joaovpzdev/howtocyberdeckandstuff/cyberdeck-sar-5k/modelo3d/stl/08_calco_frente_fundo_x4.stl

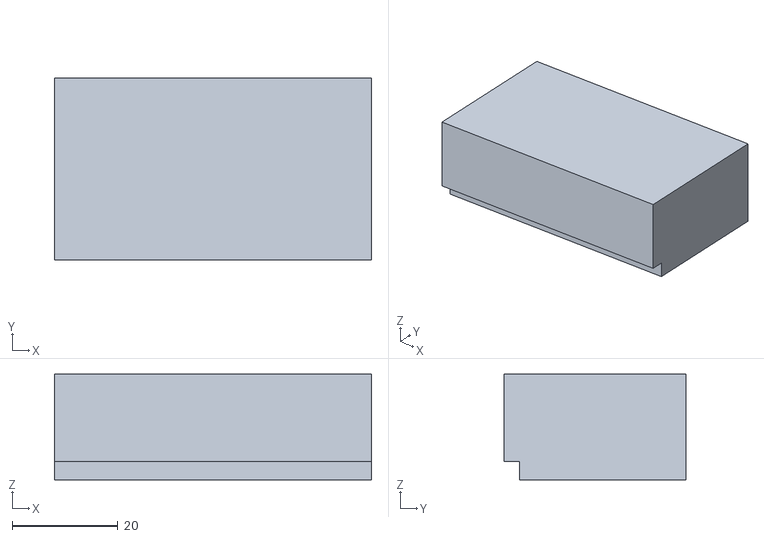
[picture p21: CAD file, 2026-10-19]
cyberdeck-sar-5k/modelo3d/stl/08_calco_frente_fundo_x4.stl
60.0 x 34.5 x 20.0
