joaovpzdev/howtocyberdeckandstuff/cyberdeck-sar-completo/modelo3d/stl/00_montagem_referencia.stl

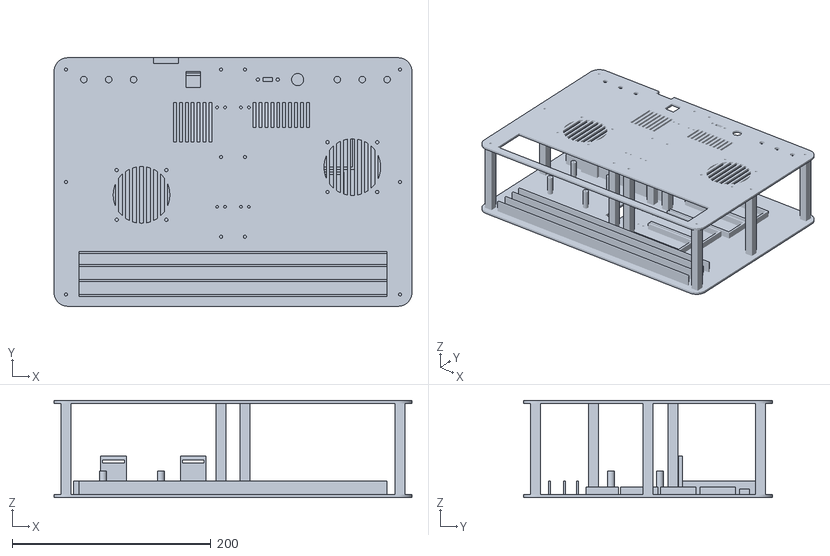
[picture p22: CAD file, 2026-10-19]
cyberdeck-sar-completo/modelo3d/stl/00_montagem_referencia.stl
360.0 x 250.0 x 98.0
