joaovpzdev/howtocyberdeckandstuff/cyberdeck-sar-5k/modelo3d/stl/03_painel_esquerdo.stl

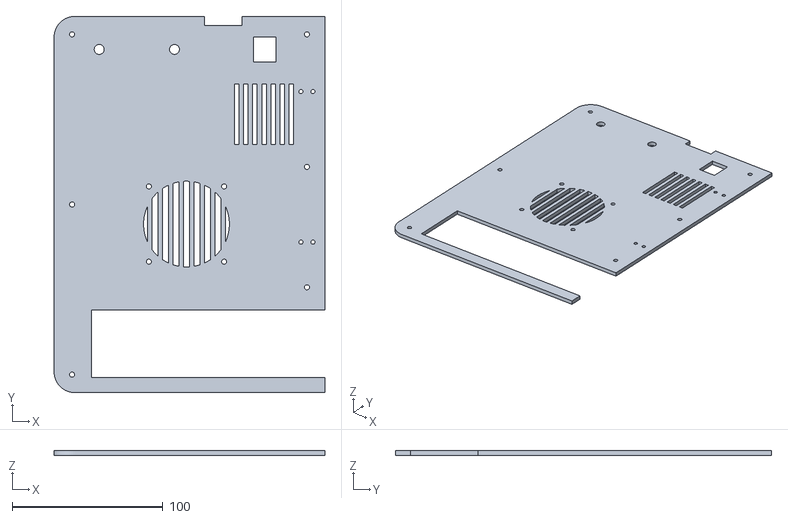
[picture p23: CAD file, 2026-10-19]
cyberdeck-sar-5k/modelo3d/stl/03_painel_esquerdo.stl
180.0 x 250.0 x 3.00
