joaovpzdev/howtocyberdeckandstuff/cyberdeck-sar-completo/modelo3d/stl/01_bandeja_esquerda.stl

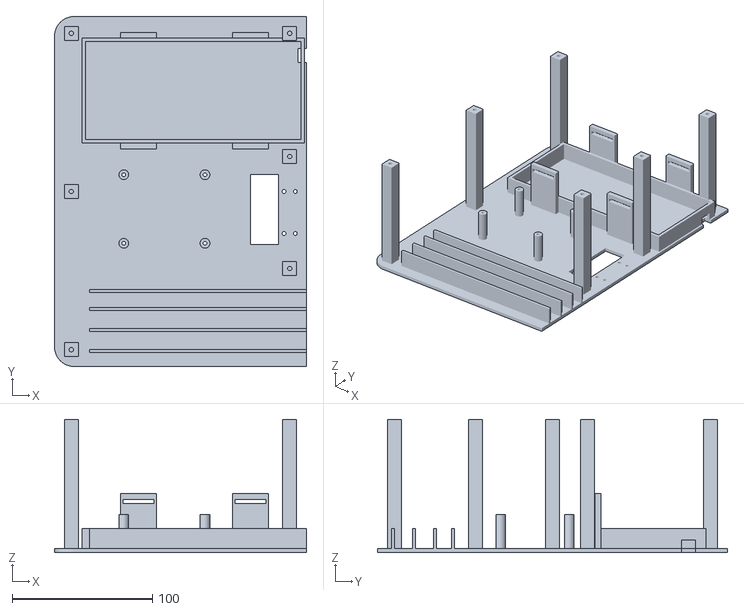
[picture p24: CAD file, 2026-10-19]
cyberdeck-sar-completo/modelo3d/stl/01_bandeja_esquerda.stl
180.0 x 250.0 x 95.0
