joaovpzdev/howtocyberdeckandstuff/cyberdeck-sar-5k/modelo3d/stl/02_bandeja_direita.stl

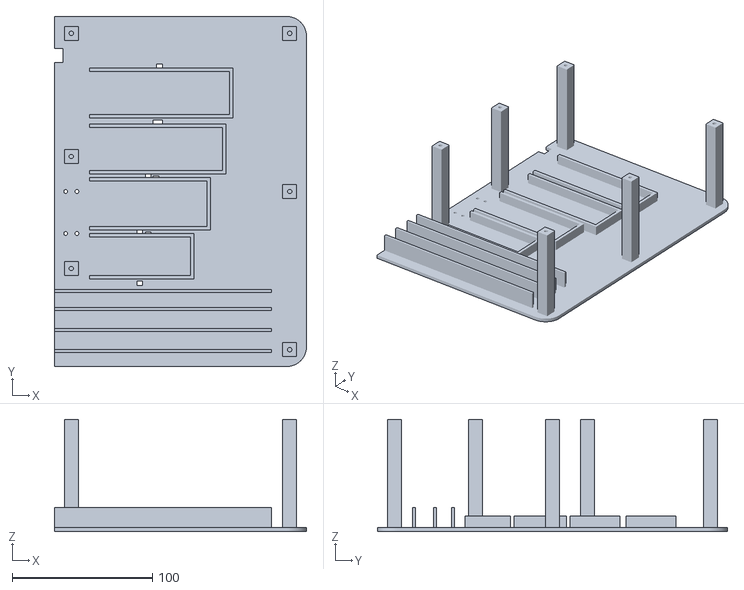
[picture p25: CAD file, 2026-10-19]
cyberdeck-sar-5k/modelo3d/stl/02_bandeja_direita.stl
180.0 x 250.0 x 80.0
