joaovpzdev/howtocyberdeckandstuff/cyberdeck-sar-completo/modelo3d/stl/05_moldura_tela.stl

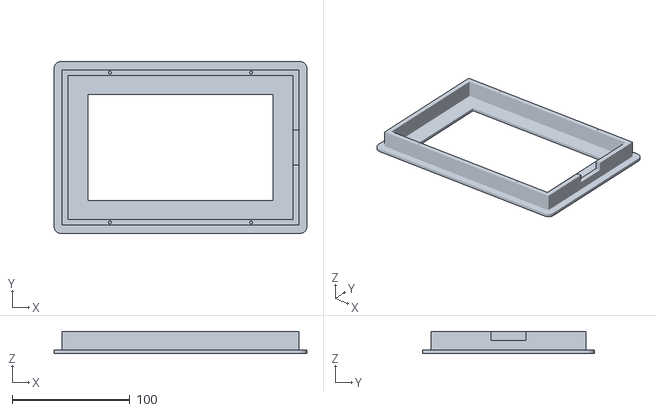
[picture p26: CAD file, 2026-10-19]
cyberdeck-sar-completo/modelo3d/stl/05_moldura_tela.stl
215.0 x 146.0 x 19.0
