joaovpzdev/howtocyberdeckandstuff/cyberdeck-sar-completo/modelo3d/stl/07_tala_emenda_x4.stl

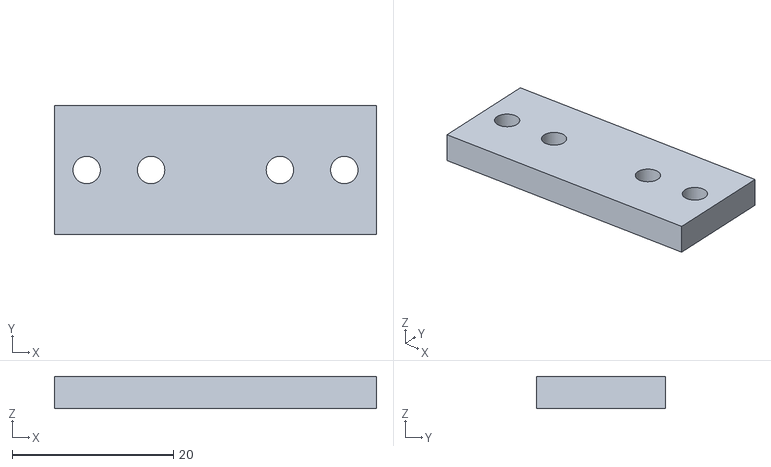
[picture p27: CAD file, 2026-10-19]
cyberdeck-sar-completo/modelo3d/stl/07_tala_emenda_x4.stl
40.0 x 16.0 x 4.00
