joaovpzdev/howtocyberdeckandstuff/cyberdeck-sar-5k/modelo3d/stl/01_bandeja_esquerda.stl

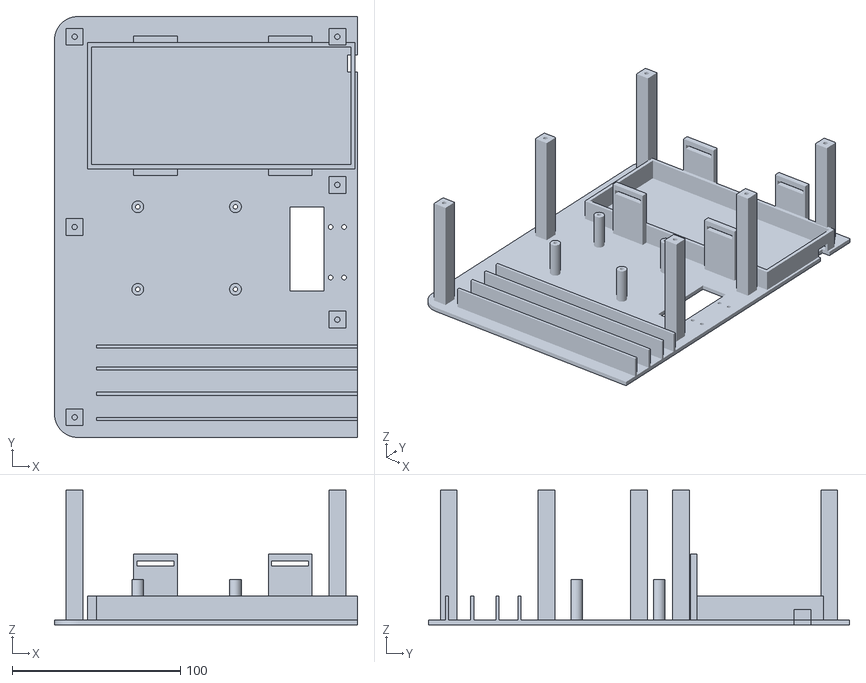
[picture p28: CAD file, 2026-10-19]
cyberdeck-sar-5k/modelo3d/stl/01_bandeja_esquerda.stl
180.0 x 250.0 x 80.0
