joaovpzdev/howtocyberdeckandstuff/cyberdeck-sar-5k/modelo3d/stl/06_travessa_tela_x2.stl

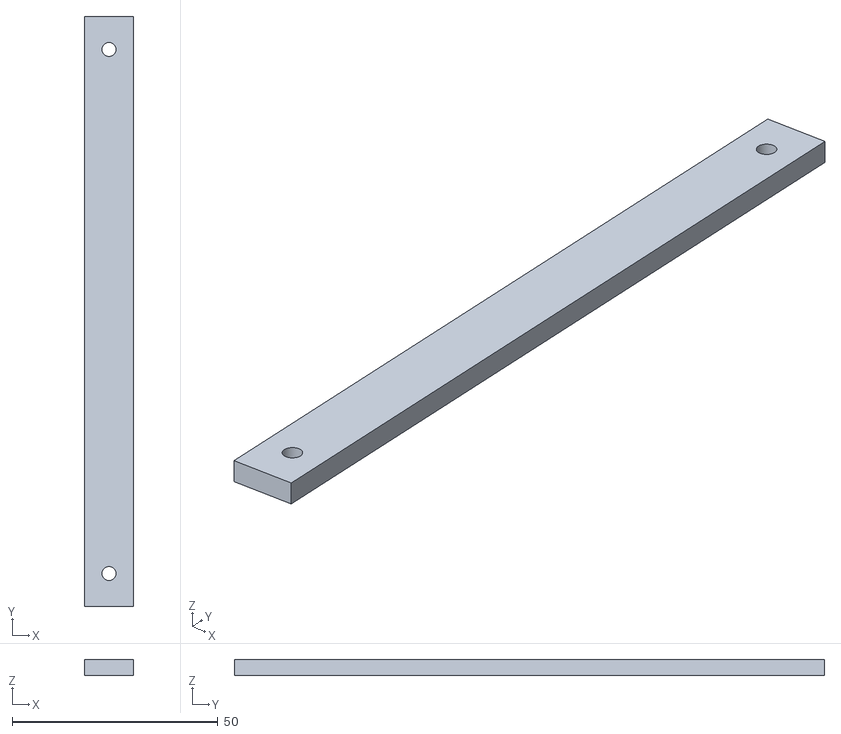
[picture p29: CAD file, 2026-10-19]
cyberdeck-sar-5k/modelo3d/stl/06_travessa_tela_x2.stl
12.0 x 143.2 x 4.00
