joaovpzdev/howtocyberdeckandstuff/cyberdeck-sar-5k/modelo3d/stl/00_montagem_referencia.stl

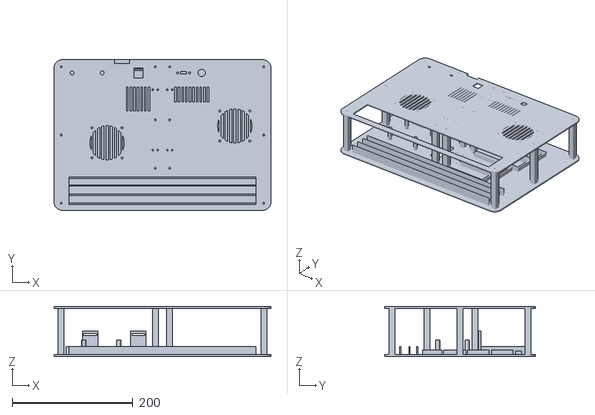
[picture p30: CAD file, 2026-10-19]
cyberdeck-sar-5k/modelo3d/stl/00_montagem_referencia.stl
360.0 x 250.0 x 83.0
