joaovpzdev/howtocyberdeckandstuff/cyberdeck-sar-5k/modelo3d/stl/09_calco_lateral_x2.stl

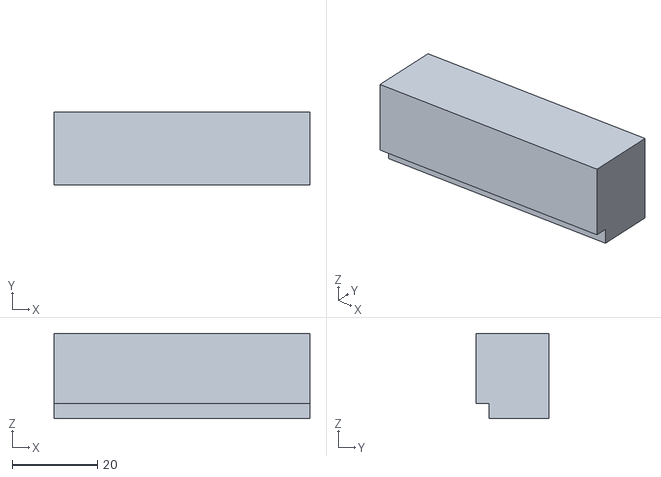
[picture p31: CAD file, 2026-10-19]
cyberdeck-sar-5k/modelo3d/stl/09_calco_lateral_x2.stl
60.0 x 17.0 x 20.0
