joaovpzdev/howtocyberdeckandstuff/(list of files, cad)

Other CAD files:
cyberdeck-sar-5k/modelo3d/stl/04_painel_direito.stl
cyberdeck-sar-completo/modelo3d/stl/04_painel_direito.stl
cyberdeck-sar-completo/modelo3d/stl/02_bandeja_direita.stl
cyberdeck-sar-completo/modelo3d/stl/03_painel_esquerdo.stl
