joaovpzdev/howtocyberdeckandstuff/cyberdeck-sar-5k/cyberdeck_sar_5k_desenho_tecnico.pdf

## CYBERDECK SAR - EDIÇÃO R$ 5 MIL

Patola MP-0039: vistas fechado e aberto em operação

Autor: João Victor Paixão Zolim
github.com/joaovpzdev

Data
17/10/2026

Escala
1:4

Folha
1/4

Unidade
mm

Projeção
1º diedro

Formato
A3

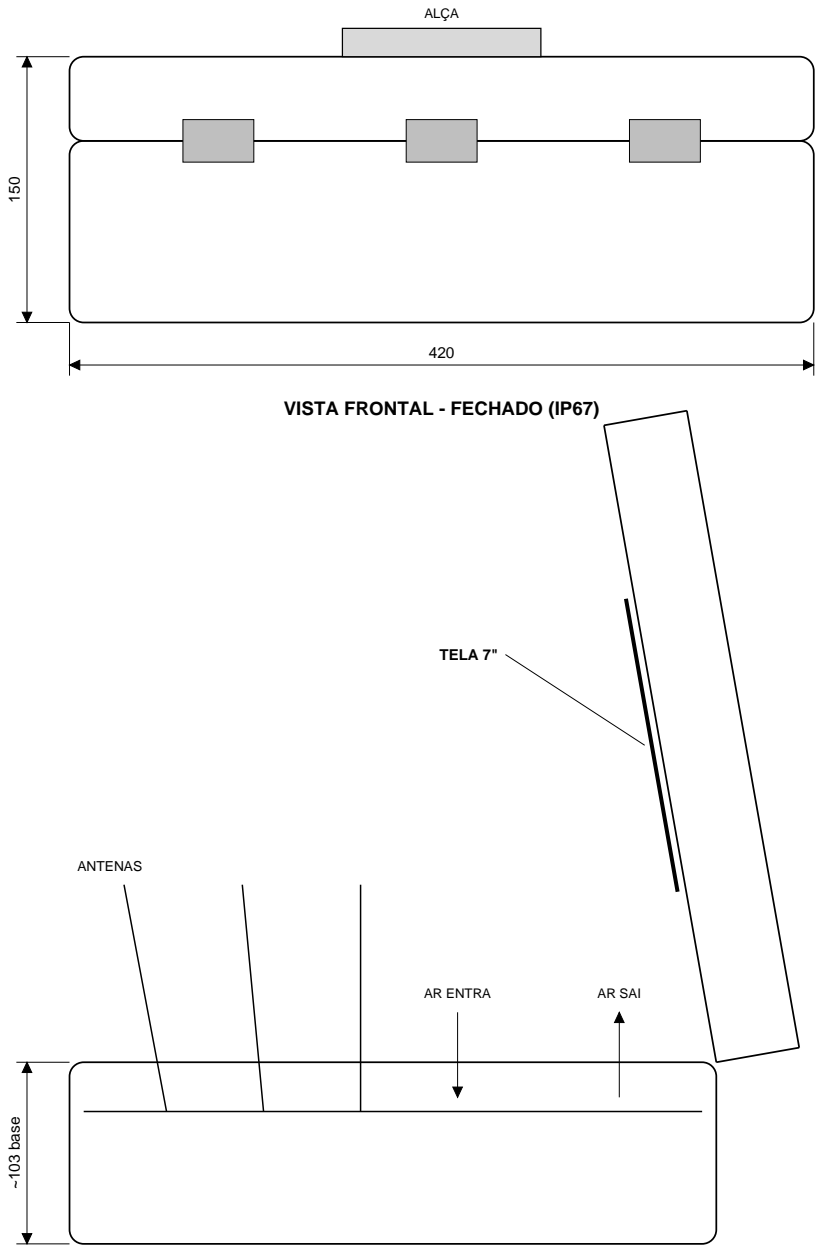
[picture p35: figure]
ALÇA; VISTA FRONTAL - FECHADO (IP67); TELA 7"; ANTENAS; AR ENTRA; AR SAI; ~103 base

DOBRADIÇA

365

### VISTA LATERAL ESQUERDA - FECHADO

### VISTA LATERAL - ABERTO EM OPERAÇÃO

Característica | Patola MP-0039 (fabricado no Brasil)
Externo (C x L x A) | 420 x 365 x 150
Interno (C x L x A) | 390 x 315 x 135
Altura interna da base / tampa | 95 / ~40
Peso vazio | 1,96 kg
Vedação | IP67 (impacto, poeira e água)
Volume interno | 16,6 litros
Compra | Patola Store (loja oficial)
Preço (out/2026) | R$ 486 (MP-0039/1: R$ 440)

Sem furos no case: a vedação IP67 fica intacta para transporte.

Em operação, o kit trabalha aberto e a ventilação é feita pelo painel.

## PROTEÇÃO PARA CLIMA HOSTIL

1. Fechado: IP67 (poeira e submersão temporária).
2. Aberto: operar sob abrigo; chuva direta molha

a tela e o painel. Prever capa/toldo.

3. Filtro de espuma na entrada de ar contra poeira.
4. Verniz conformal (tropicalização) nas placas

contra umidade e maresia.

5. Sachês de sílica gel no case fechado.
6. Peças impressas em ASA ou PETG: PLA deforma

acima de ~55 °C (sol, carro fechado).

7. Li-ion: carregar só entre 0 e 45 °C; no calor

extremo, deixar a tampa aberta e à sombra.

8. Pi 5 reduz o clock a ~85 °C: monitorar via

vcgencmd / agente Zabbix.

9. Recarga sem desmontar: USB-C do painel (tampa

aberta) -> UPS (power bank opcional). Sem furos.

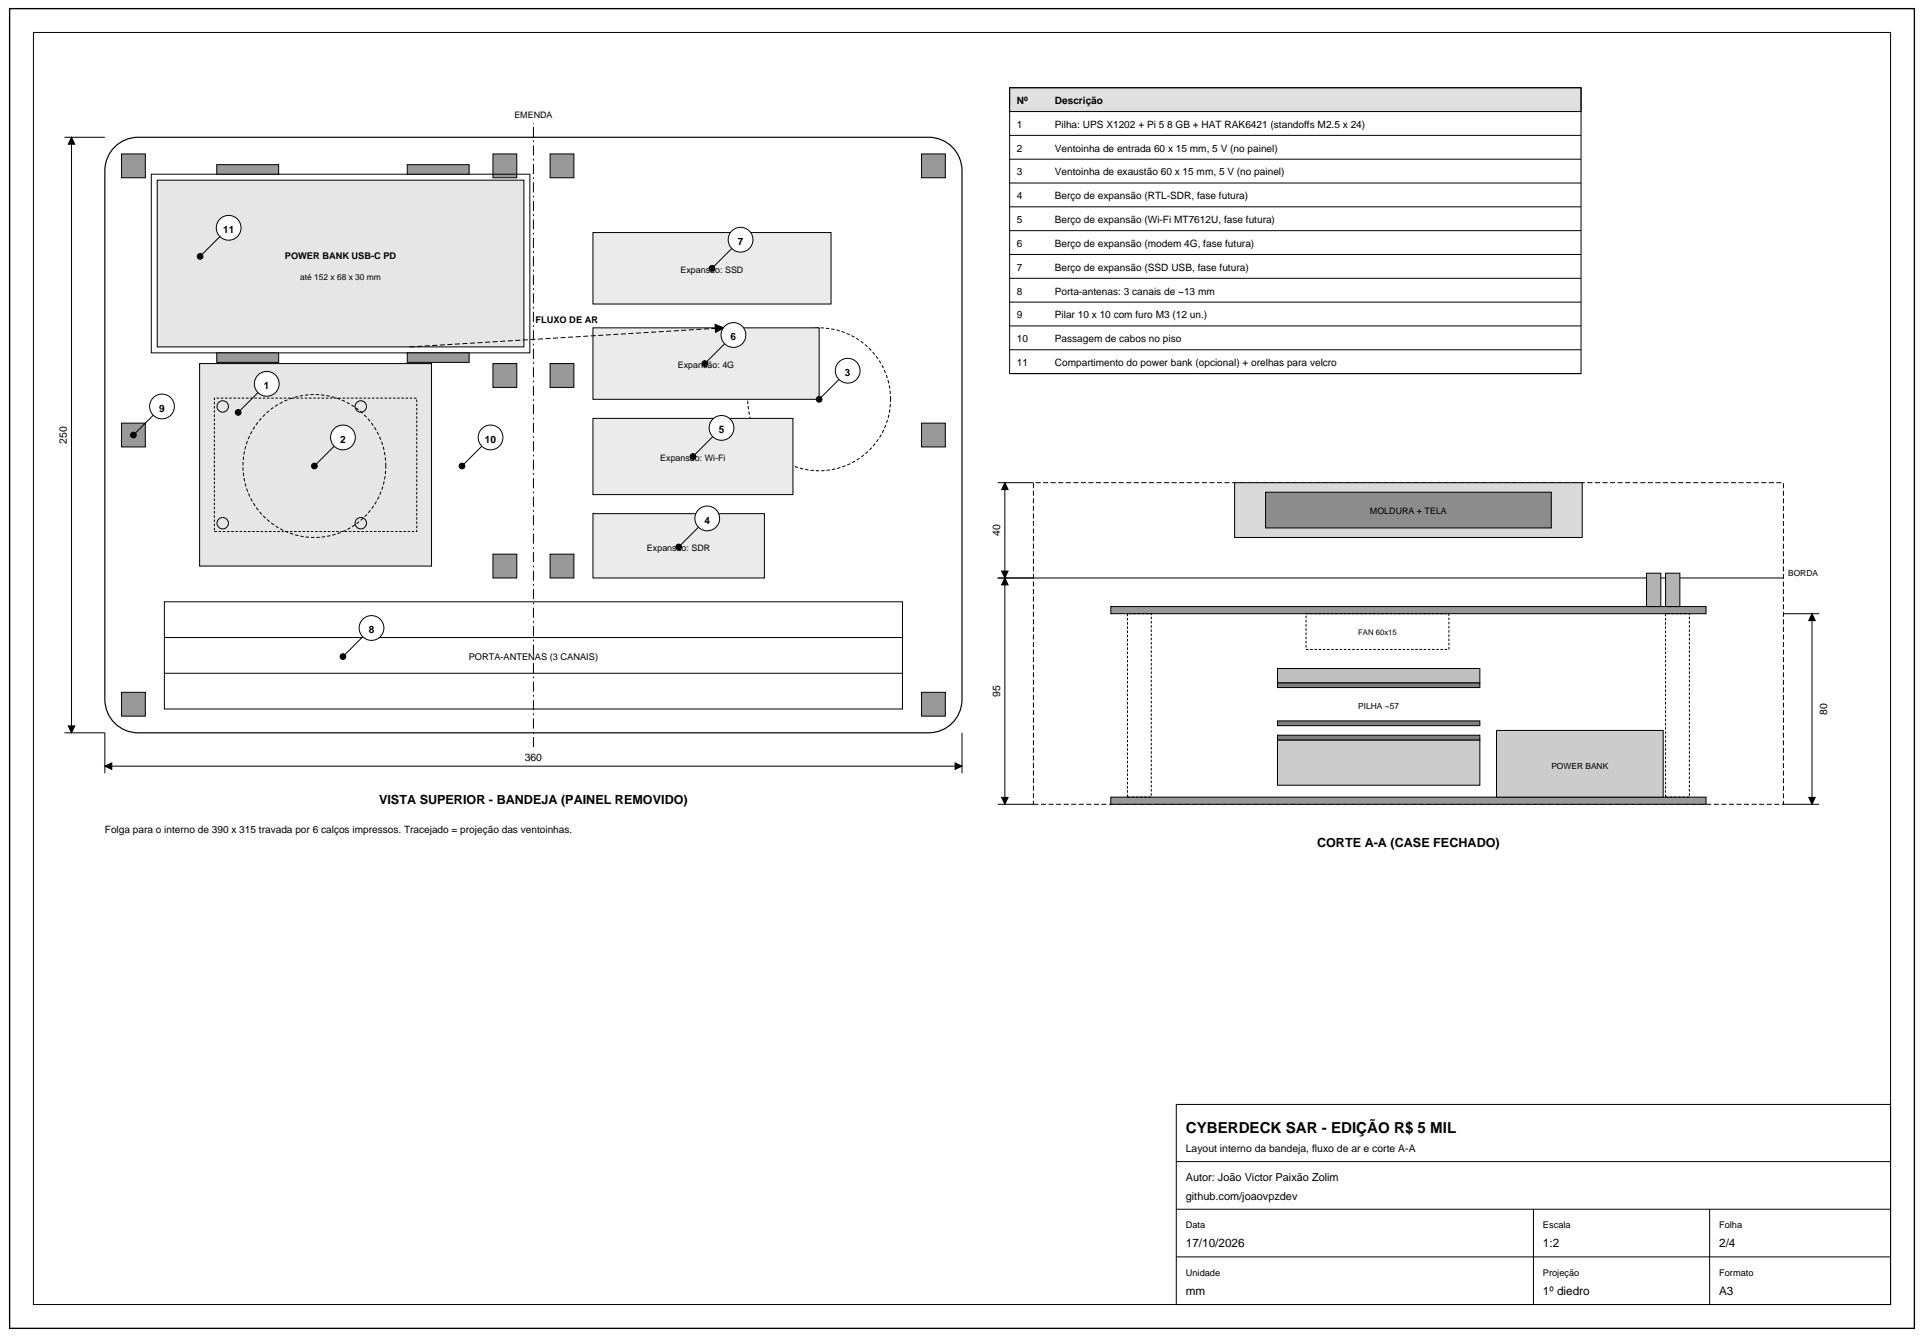
[picture p36: page 2]
Data 17/10/2026; Escala 1:2; Folha 2/4; EMENDA; Expansão: SDR; Expansão: 4G; Expansão: SSD; até 152 x 68 x 30 mm; Descrição; Pilha: UPS X1202 + Pi 5 8 GB + HAT RAK6421 (standoffs M2.5 x 24); Ventoinha de entrada 60 x 15 mm, 5 V (no painel); Ventoinha de exaustão 60 x 15 mm, 5 V (no painel); Berço de expansão (RTL-SDR, fase futura); Berço de expansão (Wi-Fi MT7612U, fase futura); Berço de expansão (modem 4G, fase futura); Berço de expansão (SSD USB, fase futura)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

POWER BANK USB-C PD

FLUXO DE AR

Expansão: Wi-Fi

PORTA-ANTENAS (3 CANAIS)

VISTA SUPERIOR - BANDEJA (PAINEL REMOVIDO)

Folga para o interno de 390 x 315 travada por 6 calços impressos. Tracejado = projeção das ventoinhas.

CORTE A-A (CASE FECHADO)

CYBERDECK SAR - EDIÇÃO R$ 5 MIL

Layout interno da bandeja, fluxo de ar e corte A-A

Autor: João Victor Paixão Zolim
github.com/joaovpzdev

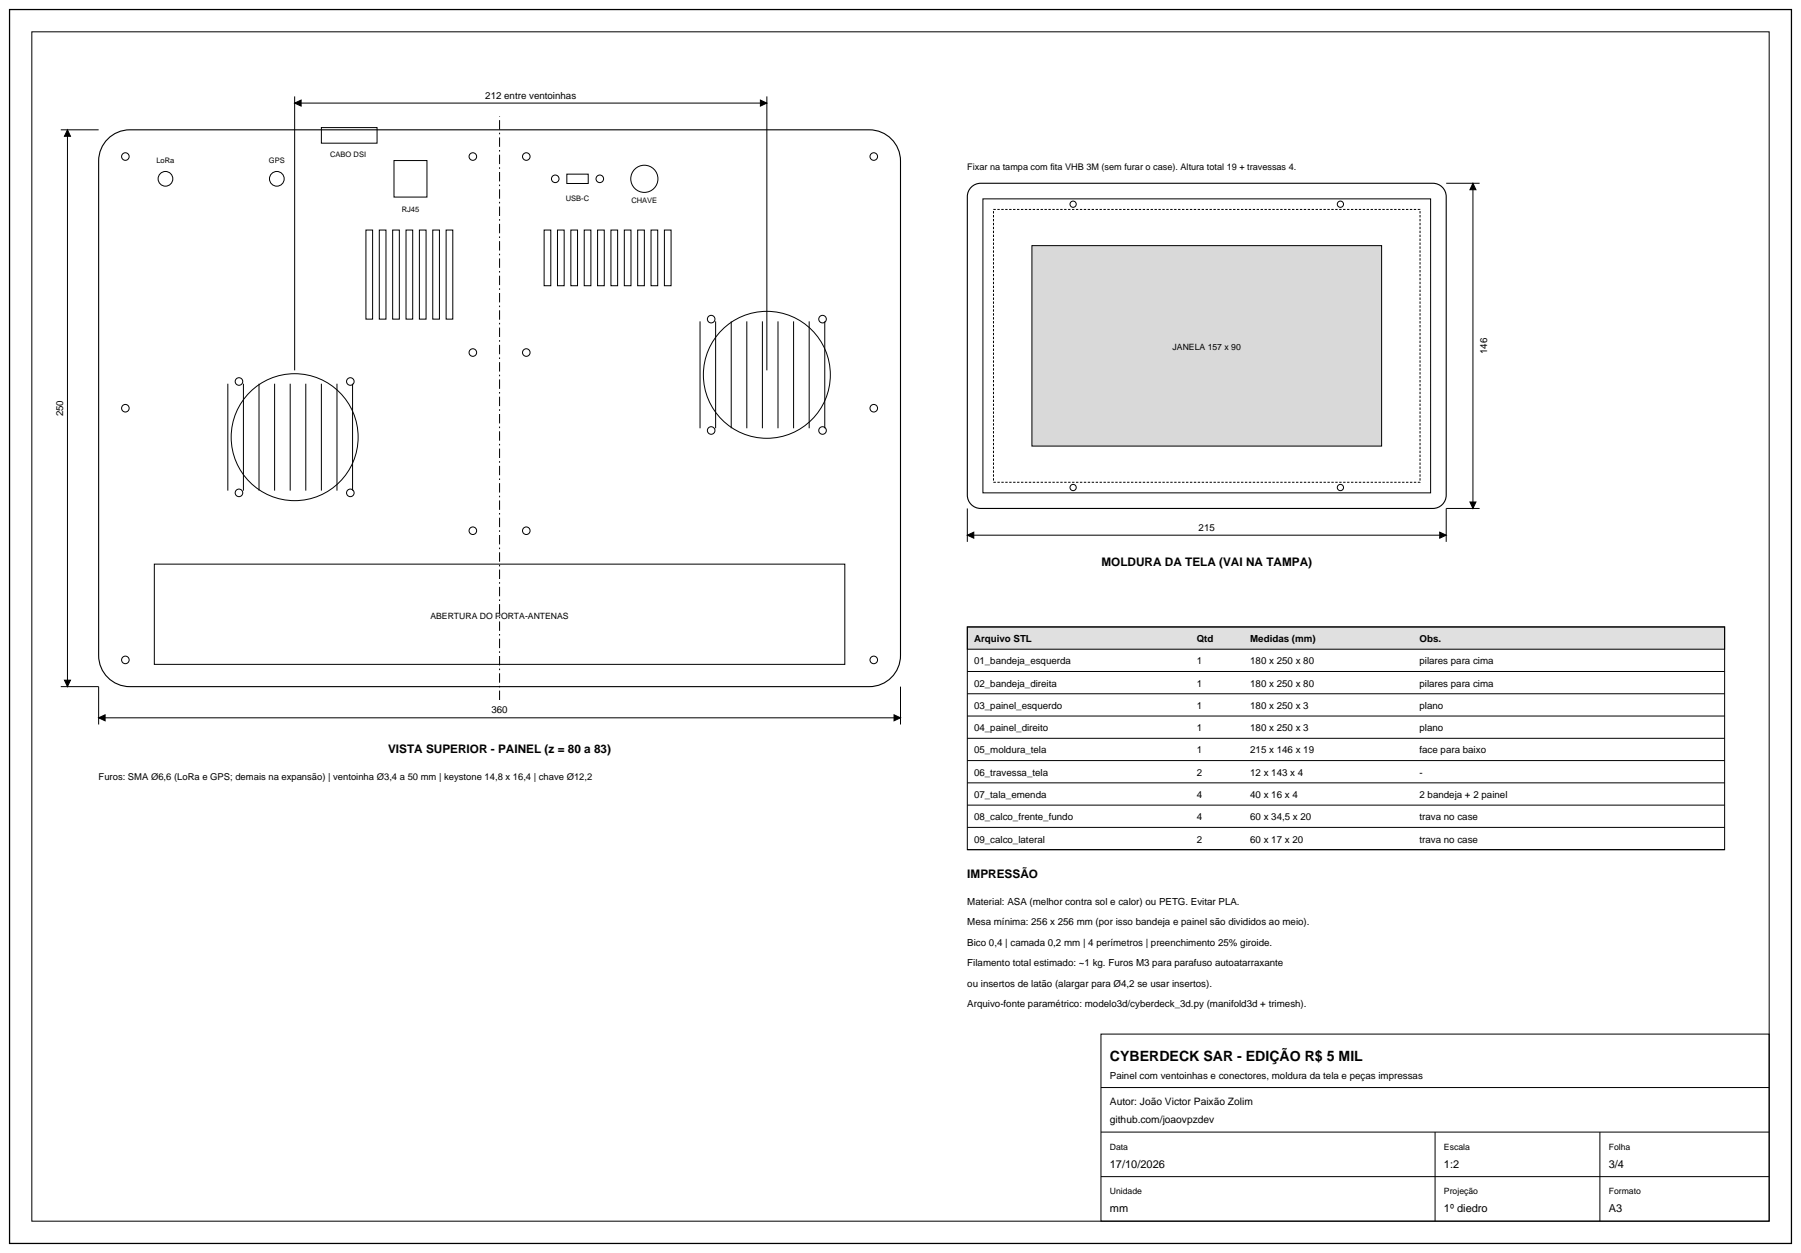
[picture p37: page 3]
Data 17/10/2026; Escala 1:2; Folha 3/4; LoRa; GPS; USB-C; CHAVE; CABO DSI; 212 entre ventoinhas; JANELA 157 x 90; Arquivo STL; Qtd; Medidas (mm); Obs.; 01_bandeja_esquerda; pilares para cima; 02_bandeja_direita; 03_painel_esquerdo; plano; 04_painel_direito; 05_moldura_tela; face para baixo; 06_travessa_tela; 07_tala_emenda; 2 bandeja + 2 painel; 08_calco_frente_fundo; trava no case; 09_calco_lateral; IMPRESSÃO

Fixar na tampa com fita VHB 3M (sem furar o case). Altura total 19 + travessas 4.

MOLDURA DA TELA (VAI NA TAMPA)

ABERTURA DO PORTA-ANTENAS

VISTA SUPERIOR - PAINEL (z = 80 a 83)

Furos: SMA Ø6,6 (LoRa e GPS; demais na expansão) | ventoinha Ø3,4 a 50 mm | keystone 14,8 x 16,4 | chave Ø12,2

Material: ASA (melhor contra sol e calor) ou PETG. Evitar PLA.
Mesa mínima: 256 x 256 mm (por isso bandeja e painel são divididos ao meio).
Bico 0,4 | camada 0,2 mm | 4 perímetros | preenchimento 25% giroide.
Filamento total estimado: ~1 kg. Furos M3 para parafuso autoatarraxante
ou insertos de latão (alargar para Ø4,2 se usar insertos).
Arquivo-fonte paramétrico: modelo3d/cyberdeck_3d.py (manifold3d + trimesh).

CYBERDECK SAR - EDIÇÃO R$ 5 MIL

Painel com ventoinhas e conectores, moldura da tela e peças impressas

Autor: João Victor Paixão Zolim
github.com/joaovpzdev

# DIAGRAMA DE BLOCOS

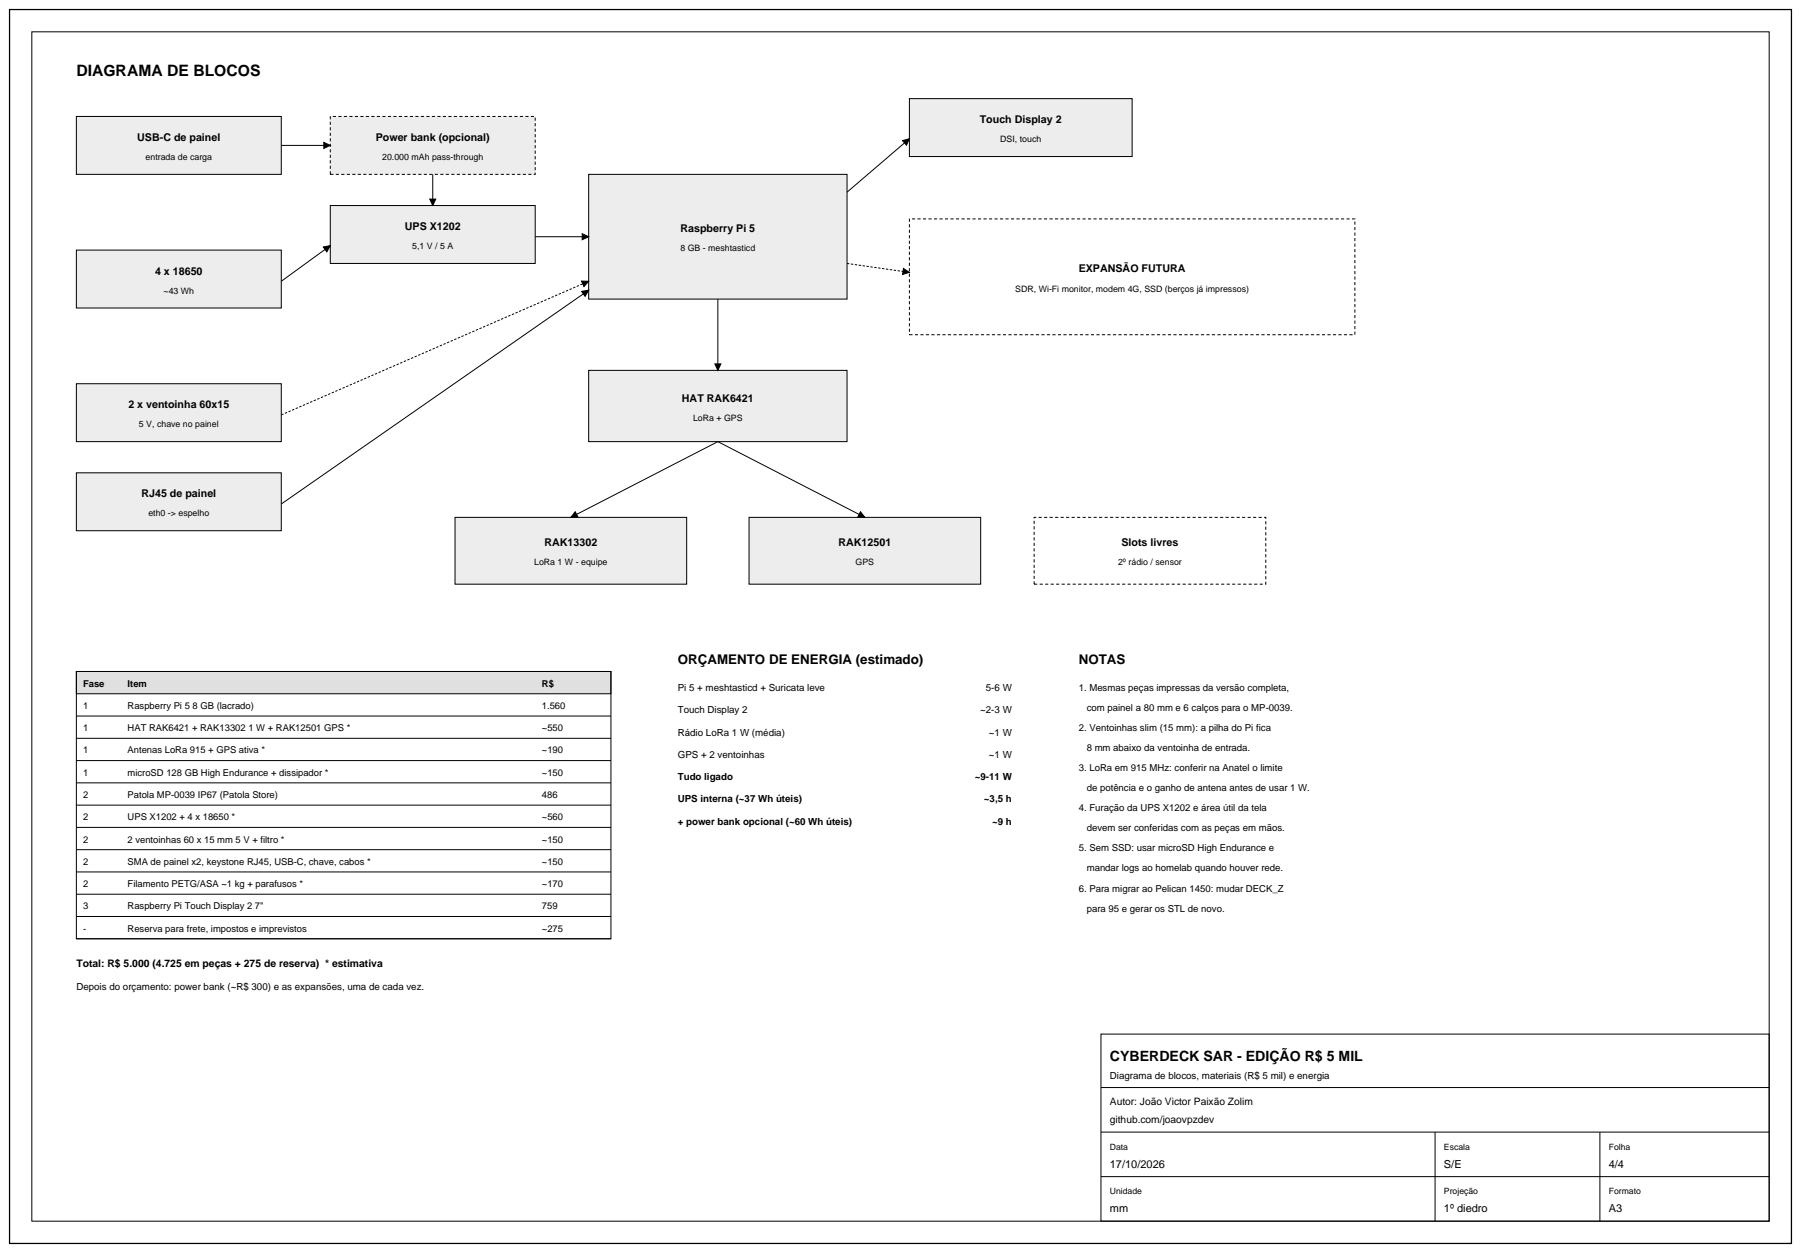
[picture p38: page 4]
Data 17/10/2026; Escala S/E; Folha 4/4; UPS X1202; Raspberry Pi 5; 8 GB - meshtasticd; HAT RAK6421; LoRa + GPS; RAK13302; LoRa 1 W - equipe; RAK12501; GPS; Slots livres; 2º rádio / sensor; Touch Display 2; DSI, touch; EXPANSÃO FUTURA; 2 x ventoinha 60x15; RJ45 de painel; eth0 -> espelho; Fase; Item; Raspberry Pi 5 8 GB (lacrado); HAT RAK6421 + RAK13302 1 W + RAK12501 GPS *; Antenas LoRa 915 + GPS ativa *; microSD 128 GB High Endurance + dissipador *; Patola MP-0039 IP67 (Patola Store)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

USB-C de painel

Power bank (opcional)

entrada de carga

20.000 mAh pass-through

SDR, Wi-Fi monitor, modem 4G, SSD (berços já impressos)

5 V, chave no painel

ORÇAMENTO DE ENERGIA (estimado)

1. Mesmas peças impressas da versão completa,
com painel a 80 mm e 6 calços para o MP-0039.
2. Ventoinhas slim (15 mm): a pilha do Pi fica
8 mm abaixo da ventoinha de entrada.
3. LoRa em 915 MHz: conferir na Anatel o limite
de potência e o ganho de antena antes de usar 1 W.
4. Furação da UPS X1202 e área útil da tela
devem ser conferidas com as peças em mãos.
5. Sem SSD: usar microSD High Endurance e
mandar logs ao homelab quando houver rede.
6. Para migrar ao Pelican 1450: mudar DECK_Z
para 95 e gerar os STL de novo.

Total: R$ 5.000 (4.725 em peças + 275 de reserva) * estimativa

Depois do orçamento: power bank (~R$ 300) e as expansões, uma de cada vez.

CYBERDECK SAR - EDIÇÃO R$ 5 MIL

Diagrama de blocos, materiais (R$ 5 mil) e energia

Autor: João Victor Paixão Zolim
github.com/joaovpzdev
