joaovpzdev/howtocyberdeckandstuff/cyberdeck-sar-completo/cyberdeck_sar_pelican1450_desenho_tecnico.pdf

## PROTEÇÃO PARA CLIMA HOSTIL

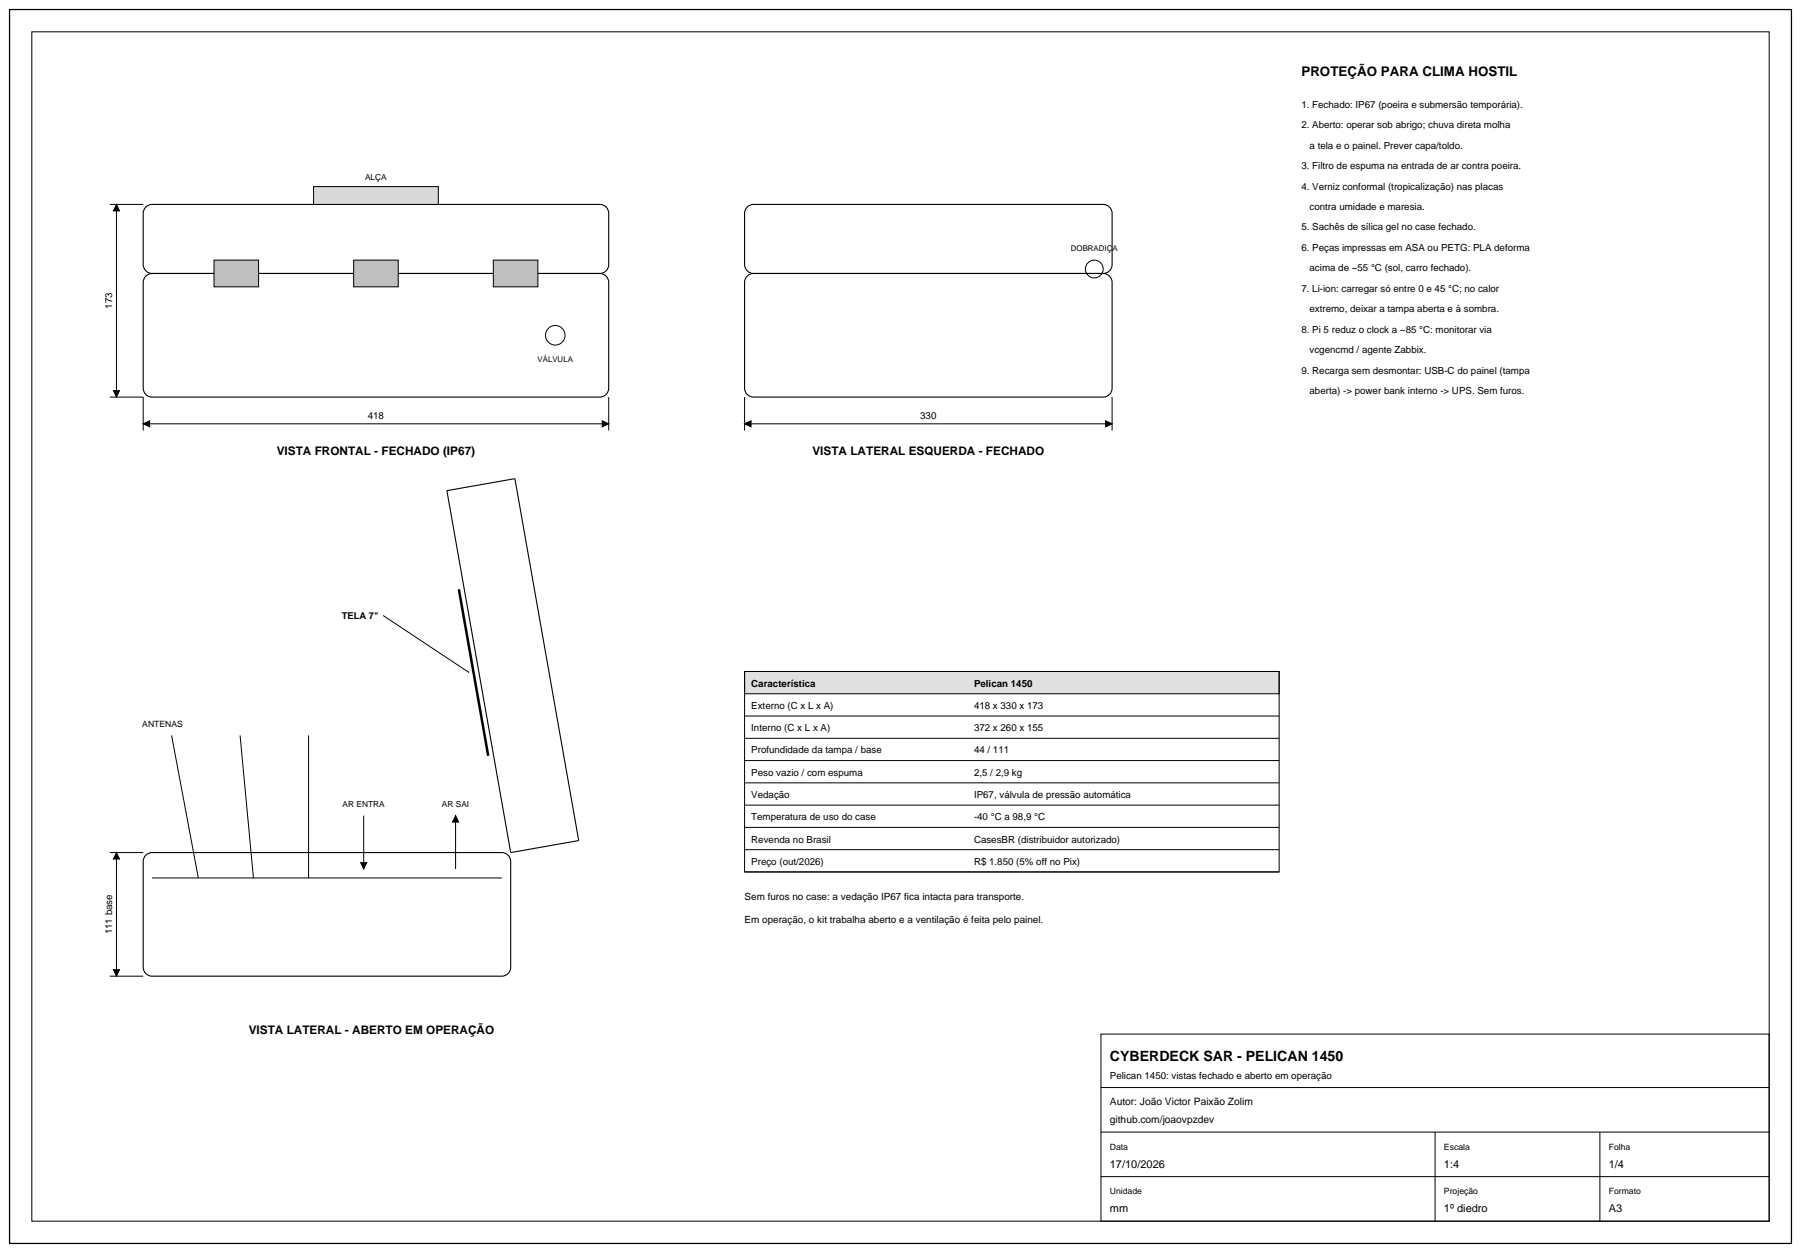
[picture p39: page 1]
Data 17/10/2026; Escala 1:4; Folha 1/4; Unidade mm; Projeção 1º diedro; Formato A3; ALÇA; VÁLVULA; DOBRADIÇA; TELA 7"; ANTENAS; AR ENTRA; AR SAI; 111 base; Característica; Pelican 1450; Externo (C x L x A); Interno (C x L x A); Profundidade da tampa / base; Peso vazio / com espuma; Vedação; IP67, válvula de pressão automática; Temperatura de uso do case; Revenda no Brasil; CasesBR (distribuidor autorizado); Preço (out/2026); R$ 1.850 (5% off no Pix)

1. Fechado: IP67 (poeira e submersão temporária).
2. Aberto: operar sob abrigo; chuva direta molha
a tela e o painel. Prever capa/toldo.
3. Filtro de espuma na entrada de ar contra poeira.
4. Verniz conformal (tropicalização) nas placas
contra umidade e maresia.
5. Sachês de sílica gel no case fechado.
6. Peças impressas em ASA ou PETG: PLA deforma
acima de ~55 °C (sol, carro fechado).
7. Li-ion: carregar só entre 0 e 45 °C; no calor
extremo, deixar a tampa aberta e à sombra.
8. Pi 5 reduz o clock a ~85 °C: monitorar via
vcgencmd / agente Zabbix.
9. Recarga sem desmontar: USB-C do painel (tampa
aberta) -> power bank interno -> UPS. Sem furos.

VISTA FRONTAL - FECHADO (IP67)

VISTA LATERAL ESQUERDA - FECHADO

Sem furos no case: a vedação IP67 fica intacta para transporte.
Em operação, o kit trabalha aberto e a ventilação é feita pelo painel.

VISTA LATERAL - ABERTO EM OPERAÇÃO

CYBERDECK SAR - PELICAN 1450

Pelican 1450: vistas fechado e aberto em operação

Autor: João Victor Paixão Zolim
github.com/joaovpzdev

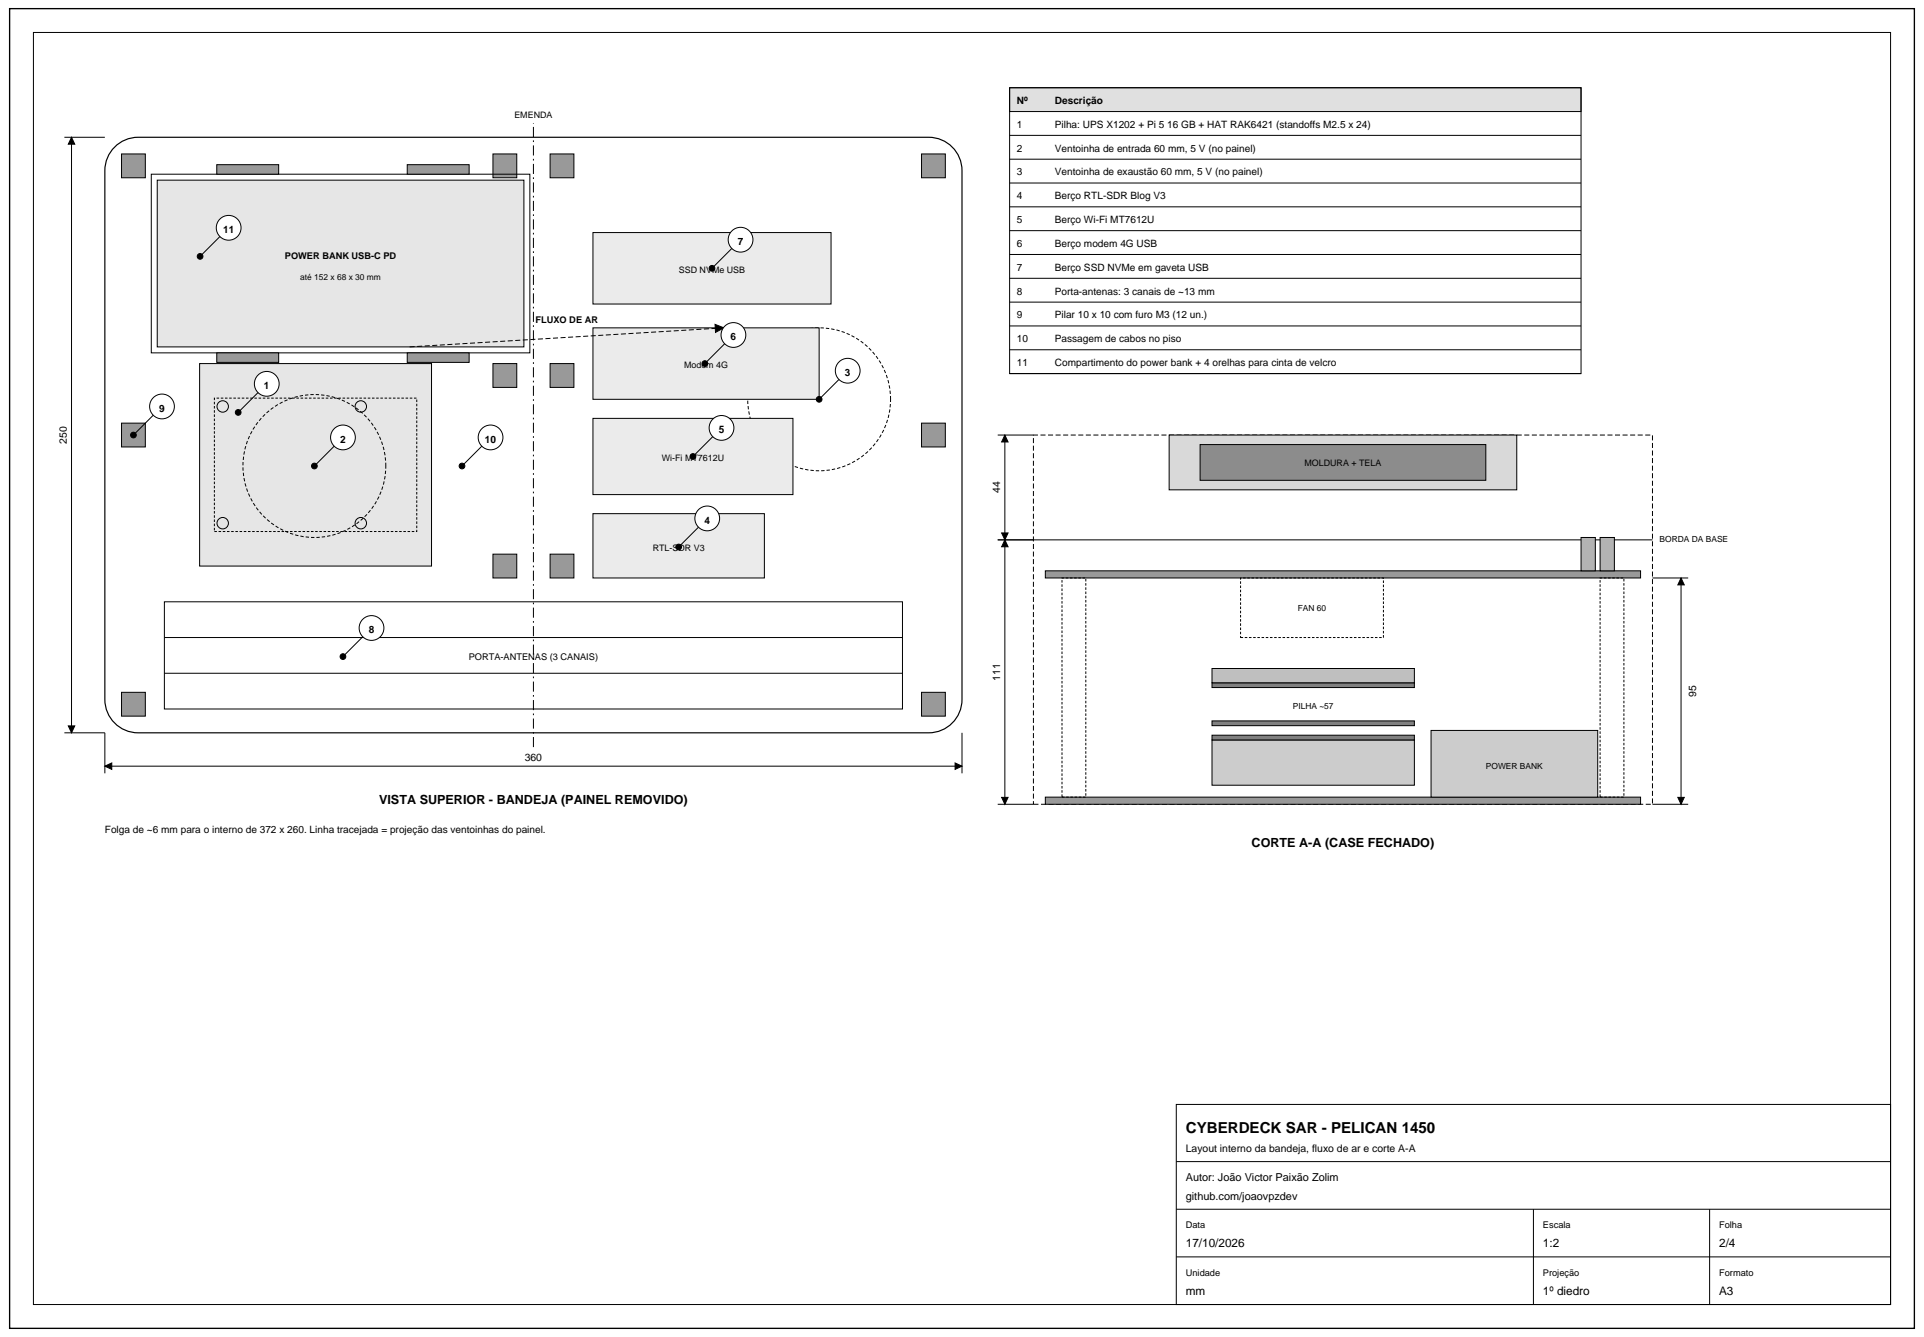
[picture p40: page 2]
Data 17/10/2026; Escala 1:2; Folha 2/4; EMENDA; RTL-SDR V3; Modem 4G; até 152 x 68 x 30 mm; Descrição; Pilha: UPS X1202 + Pi 5 16 GB + HAT RAK6421 (standoffs M2.5 x 24); Ventoinha de entrada 60 mm, 5 V (no painel); Ventoinha de exaustão 60 mm, 5 V (no painel); Berço RTL-SDR Blog V3; Berço Wi-Fi MT7612U; Berço modem 4G USB; Berço SSD NVMe em gaveta USB; Porta-antenas: 3 canais de ~13 mm; Pilar 10 x 10 com furo M3 (12 un.); Passagem de cabos no piso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

POWER BANK USB-C PD

SSD NVMe USB

FLUXO DE AR

BORDA DA BASE

PORTA-ANTENAS (3 CANAIS)

VISTA SUPERIOR - BANDEJA (PAINEL REMOVIDO)

Folga de ~6 mm para o interno de 372 x 260. Linha tracejada = projeção das ventoinhas do painel.

CORTE A-A (CASE FECHADO)

CYBERDECK SAR - PELICAN 1450

Layout interno da bandeja, fluxo de ar e corte A-A

Autor: João Victor Paixão Zolim
github.com/joaovpzdev

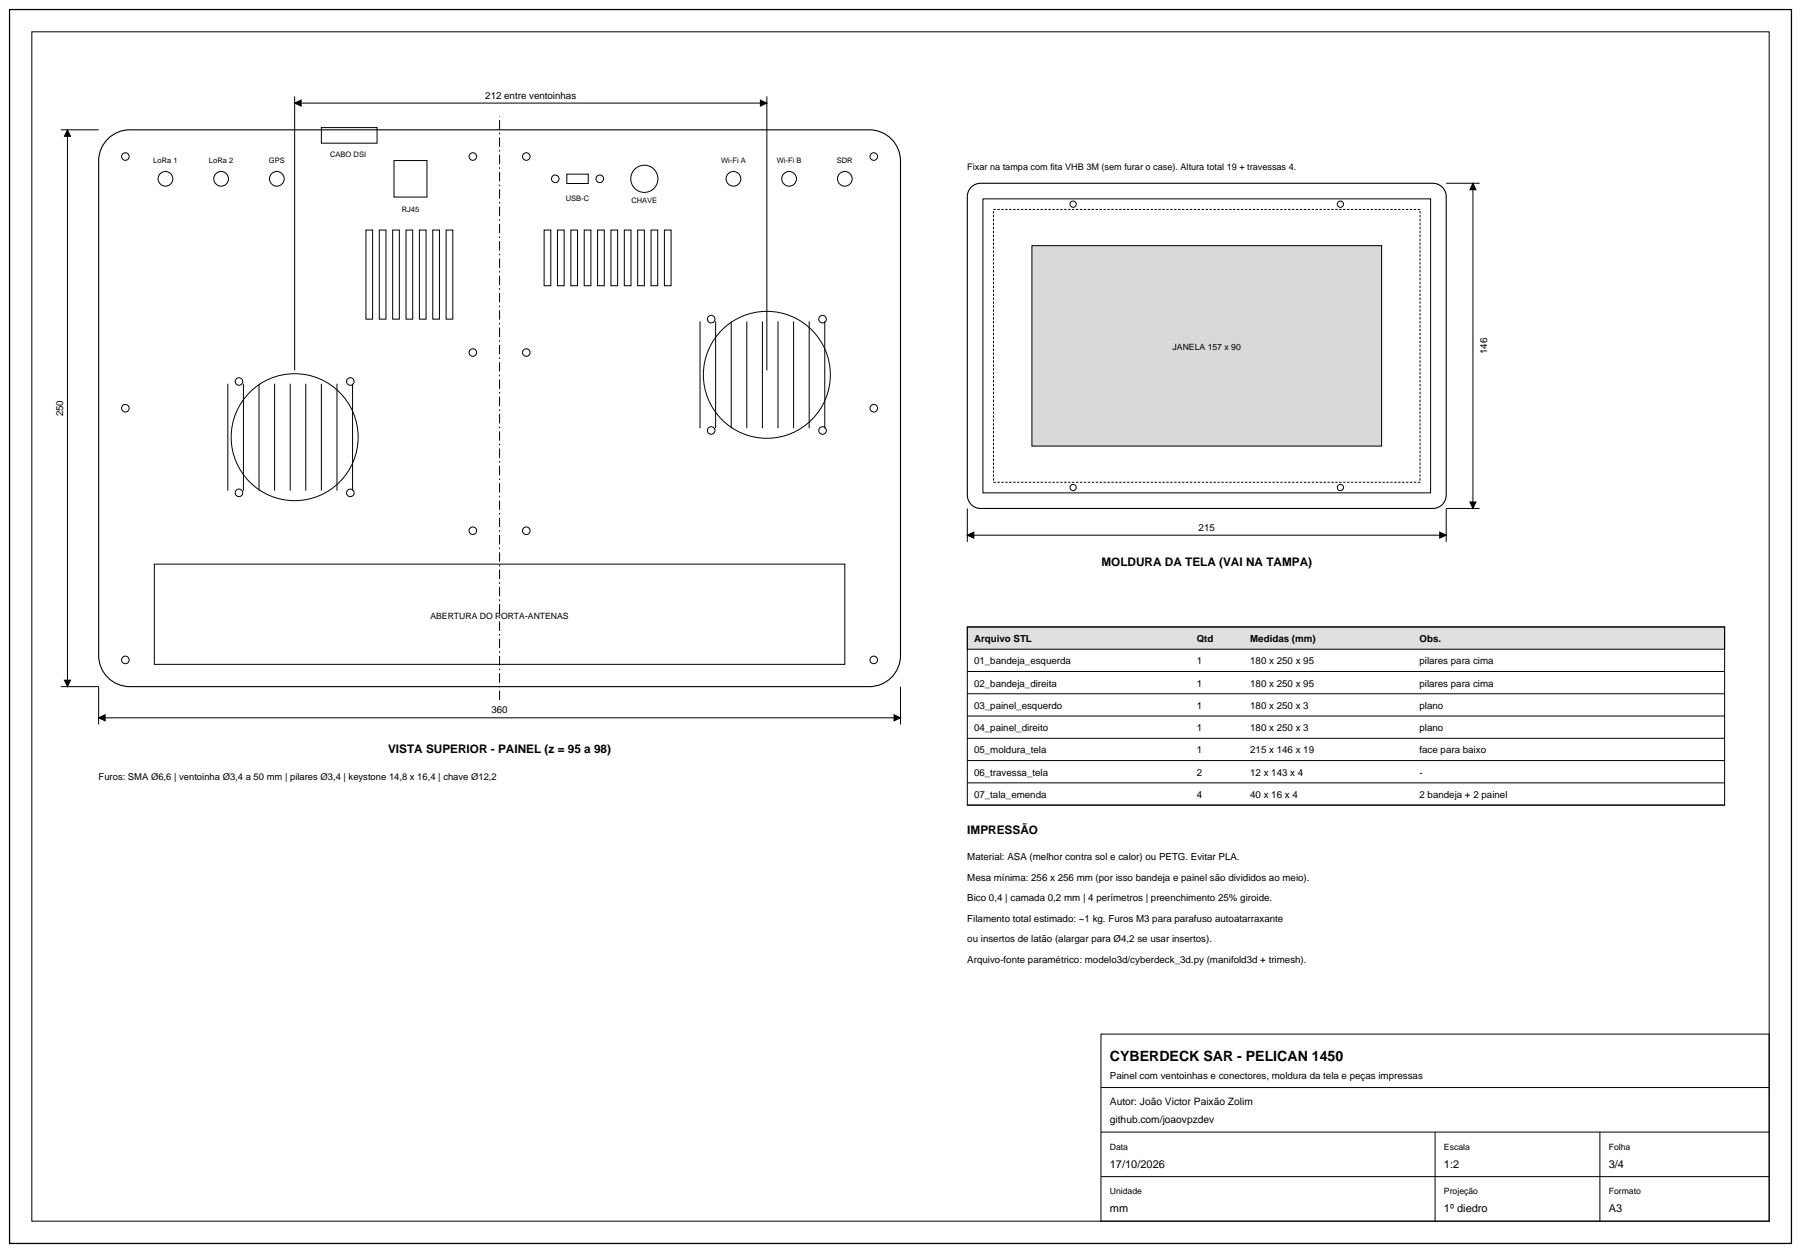
[picture p41: page 3]
Data 17/10/2026; Escala 1:2; Folha 3/4; LoRa 1; LoRa 2; GPS; SDR; USB-C; CHAVE; CABO DSI; 212 entre ventoinhas; JANELA 157 x 90; Arquivo STL; Qtd; Medidas (mm); Obs.; 01_bandeja_esquerda; pilares para cima; 02_bandeja_direita; 03_painel_esquerdo; plano; 04_painel_direito; 05_moldura_tela; face para baixo; 06_travessa_tela; 07_tala_emenda; 2 bandeja + 2 painel; IMPRESSÃO

Fixar na tampa com fita VHB 3M (sem furar o case). Altura total 19 + travessas 4.

MOLDURA DA TELA (VAI NA TAMPA)

ABERTURA DO PORTA-ANTENAS

VISTA SUPERIOR - PAINEL (z = 95 a 98)

Furos: SMA Ø6,6 | ventoinha Ø3,4 a 50 mm | pilares Ø3,4 | keystone 14,8 x 16,4 | chave Ø12,2

Material: ASA (melhor contra sol e calor) ou PETG. Evitar PLA.
Mesa mínima: 256 x 256 mm (por isso bandeja e painel são divididos ao meio).
Bico 0,4 | camada 0,2 mm | 4 perímetros | preenchimento 25% giroide.
Filamento total estimado: ~1 kg. Furos M3 para parafuso autoatarraxante
ou insertos de latão (alargar para Ø4,2 se usar insertos).
Arquivo-fonte paramétrico: modelo3d/cyberdeck_3d.py (manifold3d + trimesh).

CYBERDECK SAR - PELICAN 1450

Painel com ventoinhas e conectores, moldura da tela e peças impressas

Autor: João Victor Paixão Zolim
github.com/joaovpzdev

# DIAGRAMA DE BLOCOS

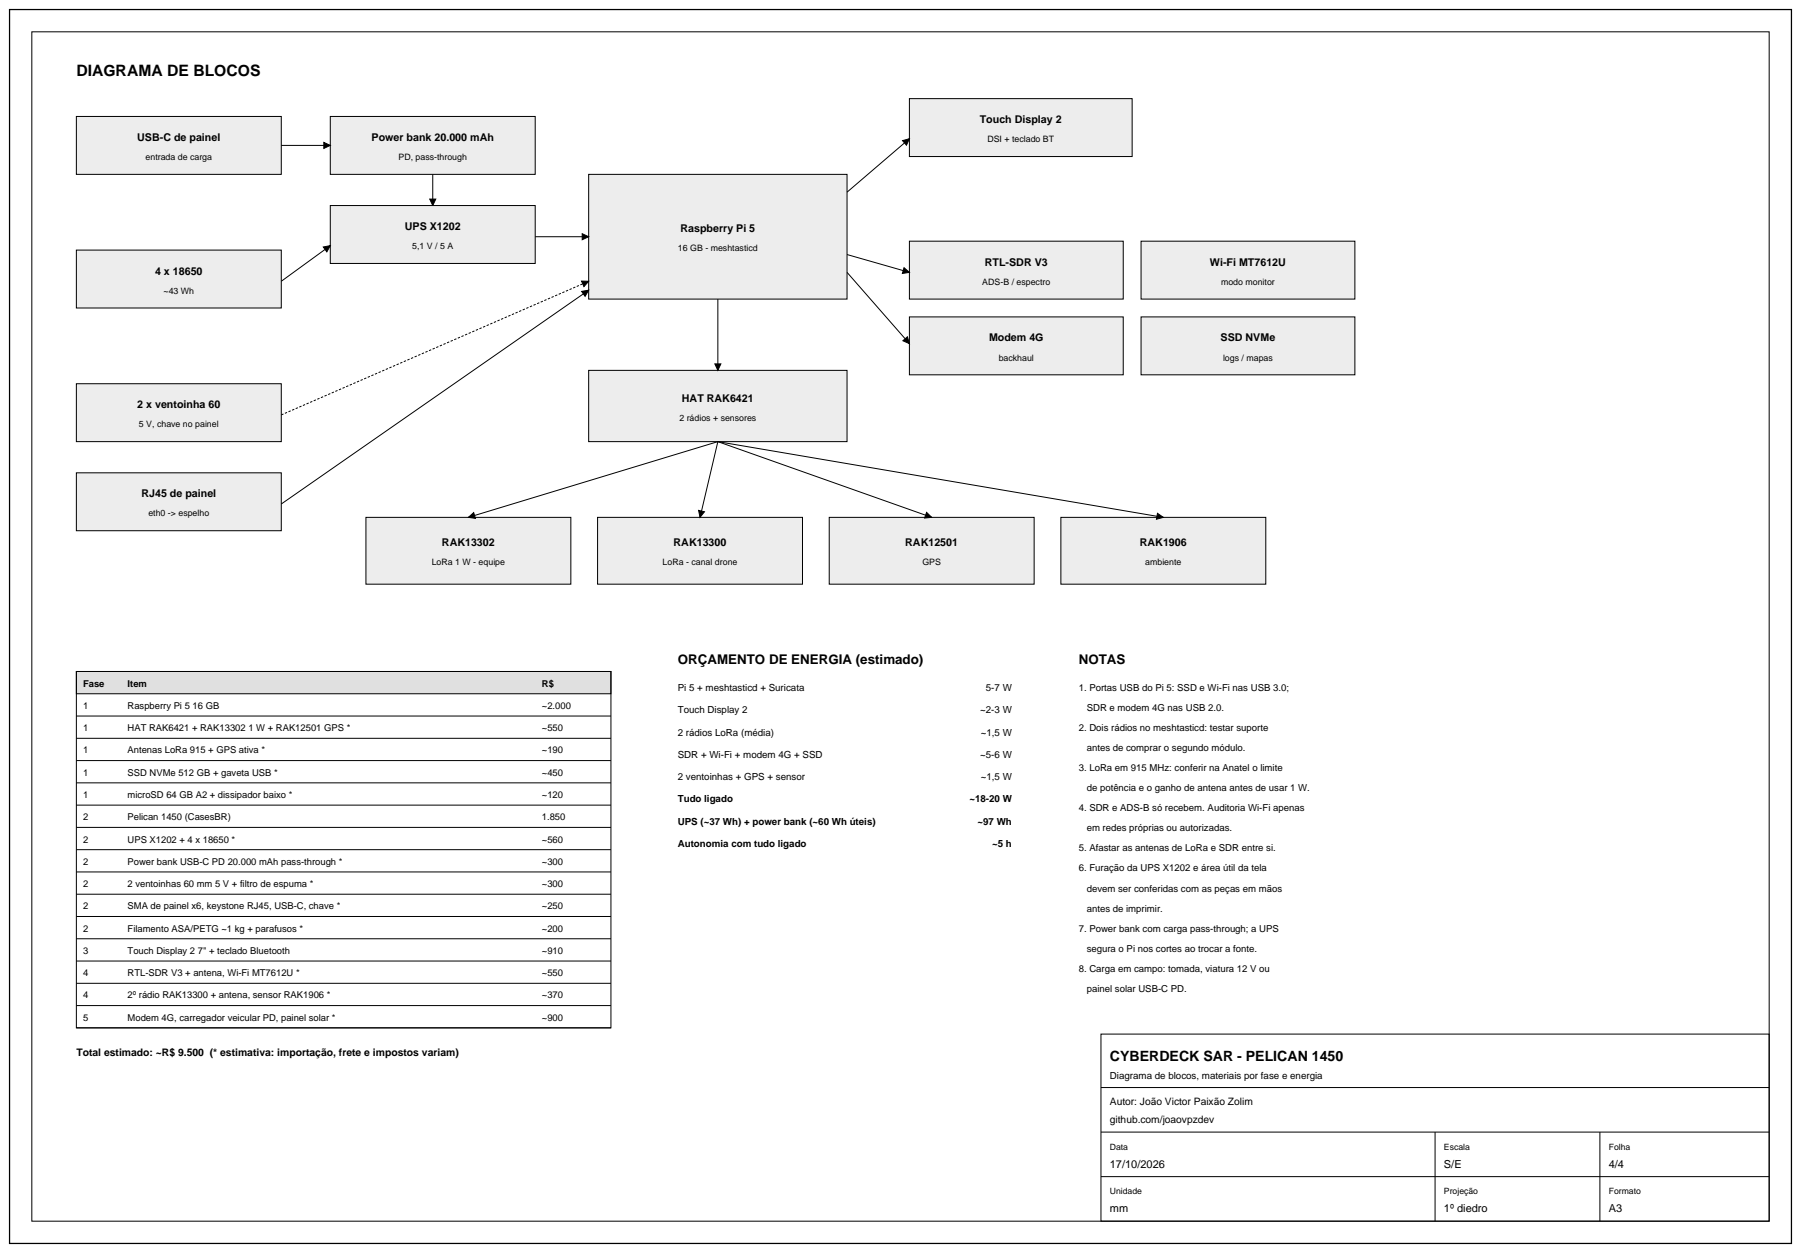
[picture p42: page 4]
Data 17/10/2026; Escala S/E; Folha 4/4; UPS X1202; Raspberry Pi 5; 16 GB - meshtasticd; HAT RAK6421; 2 rádios + sensores; RAK13302; LoRa 1 W - equipe; RAK13300; RAK12501; GPS; RAK1906; ambiente; Touch Display 2; RTL-SDR V3; ADS-B / espectro; modo monitor; Modem 4G; backhaul; SSD NVMe; logs / mapas; 2 x ventoinha 60; RJ45 de painel; eth0 -> espelho; Fase; Item; Raspberry Pi 5 16 GB; HAT RAK6421 + RAK13302 1 W + RAK12501 GPS *; Antenas LoRa 915 + GPS ativa *; SSD NVMe 512 GB + gaveta USB *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

USB-C de painel

Power bank 20.000 mAh

DSI + teclado BT

entrada de carga

PD, pass-through

5 V, chave no painel

LoRa - canal drone

ORÇAMENTO DE ENERGIA (estimado)

1. Portas USB do Pi 5: SSD e Wi-Fi nas USB 3.0;
SDR e modem 4G nas USB 2.0.
2. Dois rádios no meshtasticd: testar suporte
antes de comprar o segundo módulo.
3. LoRa em 915 MHz: conferir na Anatel o limite
de potência e o ganho de antena antes de usar 1 W.
4. SDR e ADS-B só recebem. Auditoria Wi-Fi apenas
em redes próprias ou autorizadas.
5. Afastar as antenas de LoRa e SDR entre si.
6. Furação da UPS X1202 e área útil da tela
devem ser conferidas com as peças em mãos
antes de imprimir.
7. Power bank com carga pass-through; a UPS
segura o Pi nos cortes ao trocar a fonte.
8. Carga em campo: tomada, viatura 12 V ou
painel solar USB-C PD.

Total estimado: ~R$ 9.500 (* estimativa: importação, frete e impostos variam)

CYBERDECK SAR - PELICAN 1450

Diagrama de blocos, materiais por fase e energia

Autor: João Victor Paixão Zolim
github.com/joaovpzdev
