joaovpzdev/howtocyberdeckandstuff/(commit log)

2026-10-19 Cyberdeck SAR: edições completa e R$ 5 mil
    - README com guia de montagem por componente (tema terminal)
    - Edição completa (Pelican 1450 ou Vonder MAI 415, Pi 5 16 GB)
    - Edição R$ 5 mil (Patola MP-0039, Pi 5 8 GB)
    - Desenhos técnicos, documentos, STLs e scripts geradores
    - RTL-SDR Blog V3 no lugar do V4 e Wi-Fi MT7612U no lugar do Alfa ACM
    Claude-Session: https://claude.ai/code/session_01YRm5Zd7xudzu7LtKThgQRS
    [00_montagem_referencia.stl, 01_bandeja_esquerda.stl, 02_bandeja_direita.stl, 03_painel_esquerdo.stl, 04_painel_direito.stl, 05_moldura_tela.stl, 06_travessa_tela_x2.stl, 07_tala_emenda_x4.stl]
2026-10-20 Kit portátil Nitro V15: desenho rev. B, compose e conceitos de uso
    Adiciona kit-portatil-nitro/ com desenho técnico (case Vonder MAI 415 em
    3 camadas, ligações, energia, BOM), docker-compose com perfis para o
    SDR 2, README com equipamentos x serviços, cenários de uso, integração
    com o homelab e o que transmite x o que só escuta. README central ganha
    a seção [11] kit.
    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
2026-10-21 Homelab fase 5: nó de IA, rack de GPU 2020 e guia do host EPYC
    Adiciona homelab-thinkcentre-tiny/fase5-ia/ com o desenho do nó 5
    (M720q + RTX 3060 por OCuLink), o rack de GPU em perfil 2020 para até
    5 placas com host EPYC (rev. B), o guia de implementação de 9 páginas
    e os scripts geradores. README do homelab ganha a fase 5.
    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
2026-10-21 README central: fase 5 de IA na árvore, no homelab e no roadmap
    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
2026-10-23 Homelab: estudo de núcleo alternativo com MikroTik (RB5009)
    Claude-Session: https://claude.ai/code/session_01898FGH7isfd5V2B1X4kxMN
